SuperMK15/ARC_Reactor_PCB/Arc_Reactor_PCB.step

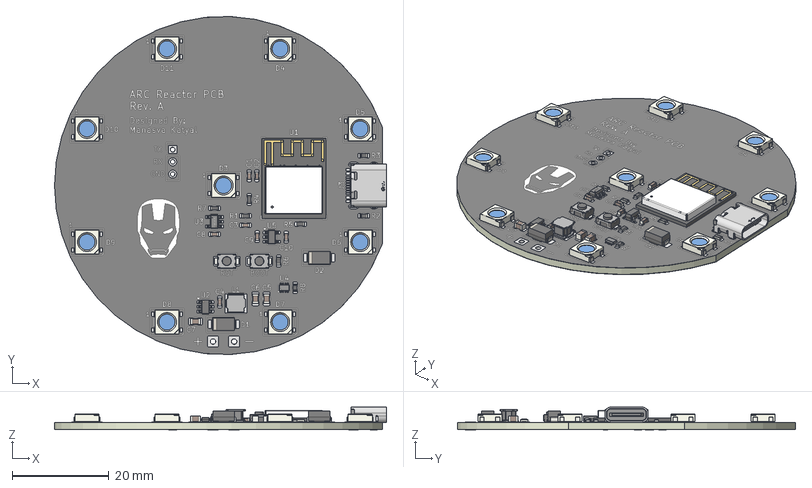
[picture p2: CAD file, 2026-10-19]
Arc_Reactor_PCB.step
68.7 x 70.0 x 4.76 mm
C_0603_1608Metric x 7
IND-SMD_L4.0-W4.0-H2.6_FNR40XXS
R_0603_1608Metric x 8
TSOT-23-6
LED_WS2812B_PLCC4_5.0x5.0mm_P3.2mm x 9
SOT-23-5_L2.9-W1.6-H1.1-LS2.8-P0.95
SW_SPST_TS-1088-xR020 x 2
DFN1006.STEP^DFN1006.STEP_Submodel-SOD882_part_DesignRootModel_PCB_ ESP32-C3-MINI-1_V1(2)_PCB_ESP32-C3-MINI-1_V1
R0201_20210301.STEP^R0201_20210301.STEP_Submodel-R0201_part_ DesignRootModel_PCB_ESP32-C3-MINI-1_V1(2)_PCB_ESP32-C3-MINI-1_V1 x 3
placementOutline^Submodel-noModelForPart_MINI-ANT-TYPED-H_1968823293_ Submodel-MINI-ANT-TYPED-H_1968823293_part_DesignRootModel_PCB_ ESP32-C3-MINI-1_V1(2)_PCB_E
placementOutline-0^Submodel-noModelForPart_MINI-ANT-TYPED-H_1968823293_ Submodel-MINI-ANT-TYPED-H_1968823293_part_DesignRootModel_PCB_ ESP32-C3-MINI-1_V1(2)_PCB
placementOutline-1^Submodel-noModelForPart_MINI-ANT-TYPED-H_1968823293_ Submodel-MINI-ANT-TYPED-H_1968823293_part_DesignRootModel_PCB_ ESP32-C3-MINI-1_V1(2)_PCB
placementOutline-2^Submodel-noModelForPart_MINI-ANT-TYPED-H_1968823293_ Submodel-MINI-ANT-TYPED-H_1968823293_part_DesignRootModel_PCB_ ESP32-C3-MINI-1_V1(2)_PCB
placementOutline-3^Submodel-noModelForPart_MINI-ANT-TYPED-H_1968823293_ Submodel-MINI-ANT-TYPED-H_1968823293_part_DesignRootModel_PCB_ ESP32-C3-MINI-1_V1(2)_PCB
placementOutline-4^Submodel-noModelForPart_MINI-ANT-TYPED-H_1968823293_ Submodel-MINI-ANT-TYPED-H_1968823293_part_DesignRootModel_PCB_ ESP32-C3-MINI-1_V1(2)_PCB
placementOutline-5^Submodel-noModelForPart_MINI-ANT-TYPED-H_1968823293_ Submodel-MINI-ANT-TYPED-H_1968823293_part_DesignRootModel_PCB_ ESP32-C3-MINI-1_V1(2)_PCB
trace_4^Submodel-MINI-ANT-TYPED-H_1968823293_part_DesignRootModel_PCB_ ESP32-C3-MINI-1_V1(2)_PCB_ESP32-C3-MINI-1_V1
trace_1^Submodel-MINI-ANT-TYPED-H_1968823293_part_DesignRootModel_PCB_ ESP32-C3-MINI-1_V1(2)_PCB_ESP32-C3-MINI-1_V1
C0402_20210301.STEP^C0402_20210301.STEP_Submodel-C0402_part_ DesignRootModel_PCB_ESP32-C3-MINI-1_V1(2)_PCB_ESP32-C3-MINI-1_V1
C0201_20210301.STEP^C0201_20210301.STEP_Submodel-C0201_part_ DesignRootModel_PCB_ESP32-C3-MINI-1_V1(2)_PCB_ESP32-C3-MINI-1_V1 x 11
L0201_20210301.STEP^L0201_20210301.STEP_Submodel-L0201_part_ DesignRootModel_PCB_ESP32-C3-MINI-1_V1(2)_PCB_ESP32-C3-MINI-1_V1 x 2
XTAL3225_20210301.STEP^XTAL3225_20210301.STEP_Submodel-XTAL3225_part_ DesignRootModel_PCB_ESP32-C3-MINI-1_V1(2)_PCB_ESP32-C3-MINI-1_V1
ESP32-C3_20210301.STEP^ESP32-C3_20210301.STEP_Submodel-QFN32_0P5_5_ part_DesignRootModel_PCB_ESP32-C3-MINI-1_V1(2)_PCB_ESP32-C3-MINI-1_V1
uid__4^DesignRootModel_PCB_ESP32-C3-MINI-1_V1(2)_PCB_ESP32-C3-MINI-1_ V1
uid__4-22^DesignRootModel_PCB_ESP32-C3-MINI-1_V1(2)_PCB_ ESP32-C3-MINI-1_V1
uid__4-23^DesignRootModel_PCB_ESP32-C3-MINI-1_V1(2)_PCB_ ESP32-C3-MINI-1_V1
uid__4-24^DesignRootModel_PCB_ESP32-C3-MINI-1_V1(2)_PCB_ ESP32-C3-MINI-1_V1
uid__4-25^DesignRootModel_PCB_ESP32-C3-MINI-1_V1(2)_PCB_ ESP32-C3-MINI-1_V1
uid__4-26^DesignRootModel_PCB_ESP32-C3-MINI-1_V1(2)_PCB_ ESP32-C3-MINI-1_V1
uid__4-27^DesignRootModel_PCB_ESP32-C3-MINI-1_V1(2)_PCB_ ESP32-C3-MINI-1_V1
uid__4-28^DesignRootModel_PCB_ESP32-C3-MINI-1_V1(2)_PCB_ ESP32-C3-MINI-1_V1
uid__4-29^DesignRootModel_PCB_ESP32-C3-MINI-1_V1(2)_PCB_ ESP32-C3-MINI-1_V1
uid__4-30^DesignRootModel_PCB_ESP32-C3-MINI-1_V1(2)_PCB_ ESP32-C3-MINI-1_V1
uid__4-31^DesignRootModel_PCB_ESP32-C3-MINI-1_V1(2)_PCB_ ESP32-C3-MINI-1_V1
uid__4-32^DesignRootModel_PCB_ESP32-C3-MINI-1_V1(2)_PCB_ ESP32-C3-MINI-1_V1
uid__4-33^DesignRootModel_PCB_ESP32-C3-MINI-1_V1(2)_PCB_ ESP32-C3-MINI-1_V1
uid__4-34^DesignRootModel_PCB_ESP32-C3-MINI-1_V1(2)_PCB_ ESP32-C3-MINI-1_V1
uid__4-35^DesignRootModel_PCB_ESP32-C3-MINI-1_V1(2)_PCB_ ESP32-C3-MINI-1_V1
uid__4-36^DesignRootModel_PCB_ESP32-C3-MINI-1_V1(2)_PCB_ ESP32-C3-MINI-1_V1
uid__4-37^DesignRootModel_PCB_ESP32-C3-MINI-1_V1(2)_PCB_ ESP32-C3-MINI-1_V1
uid__4-38^DesignRootModel_PCB_ESP32-C3-MINI-1_V1(2)_PCB_ ESP32-C3-MINI-1_V1
uid__4-39^DesignRootModel_PCB_ESP32-C3-MINI-1_V1(2)_PCB_ ESP32-C3-MINI-1_V1
uid__4-40^DesignRootModel_PCB_ESP32-C3-MINI-1_V1(2)_PCB_ ESP32-C3-MINI-1_V1
uid__4-41^DesignRootModel_PCB_ESP32-C3-MINI-1_V1(2)_PCB_ ESP32-C3-MINI-1_V1
uid__4-42^DesignRootModel_PCB_ESP32-C3-MINI-1_V1(2)_PCB_ ESP32-C3-MINI-1_V1
uid__4-43^DesignRootModel_PCB_ESP32-C3-MINI-1_V1(2)_PCB_ ESP32-C3-MINI-1_V1
uid__4-44^DesignRootModel_PCB_ESP32-C3-MINI-1_V1(2)_PCB_ ESP32-C3-MINI-1_V1
uid__4-45^DesignRootModel_PCB_ESP32-C3-MINI-1_V1(2)_PCB_ ESP32-C3-MINI-1_V1
uid__4-46^DesignRootModel_PCB_ESP32-C3-MINI-1_V1(2)_PCB_ ESP32-C3-MINI-1_V1
uid__4-47^DesignRootModel_PCB_ESP32-C3-MINI-1_V1(2)_PCB_ ESP32-C3-MINI-1_V1
uid__4-48^DesignRootModel_PCB_ESP32-C3-MINI-1_V1(2)_PCB_ ESP32-C3-MINI-1_V1
uid__4-49^DesignRootModel_PCB_ESP32-C3-MINI-1_V1(2)_PCB_ ESP32-C3-MINI-1_V1
uid__4-50^DesignRootModel_PCB_ESP32-C3-MINI-1_V1(2)_PCB_ ESP32-C3-MINI-1_V1
uid__4-51^DesignRootModel_PCB_ESP32-C3-MINI-1_V1(2)_PCB_ ESP32-C3-MINI-1_V1
uid__4-52^DesignRootModel_PCB_ESP32-C3-MINI-1_V1(2)_PCB_ ESP32-C3-MINI-1_V1
uid__4-53^DesignRootModel_PCB_ESP32-C3-MINI-1_V1(2)_PCB_ ESP32-C3-MINI-1_V1
uid__4-54^DesignRootModel_PCB_ESP32-C3-MINI-1_V1(2)_PCB_ ESP32-C3-MINI-1_V1
uid__4-55^DesignRootModel_PCB_ESP32-C3-MINI-1_V1(2)_PCB_ ESP32-C3-MINI-1_V1
uid__4-56^DesignRootModel_PCB_ESP32-C3-MINI-1_V1(2)_PCB_ ESP32-C3-MINI-1_V1
uid__4-57^DesignRootModel_PCB_ESP32-C3-MINI-1_V1(2)_PCB_ ESP32-C3-MINI-1_V1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
