SuperMK15/ARC_Reactor_PCB/Arc_Reactor_PCB.pdf

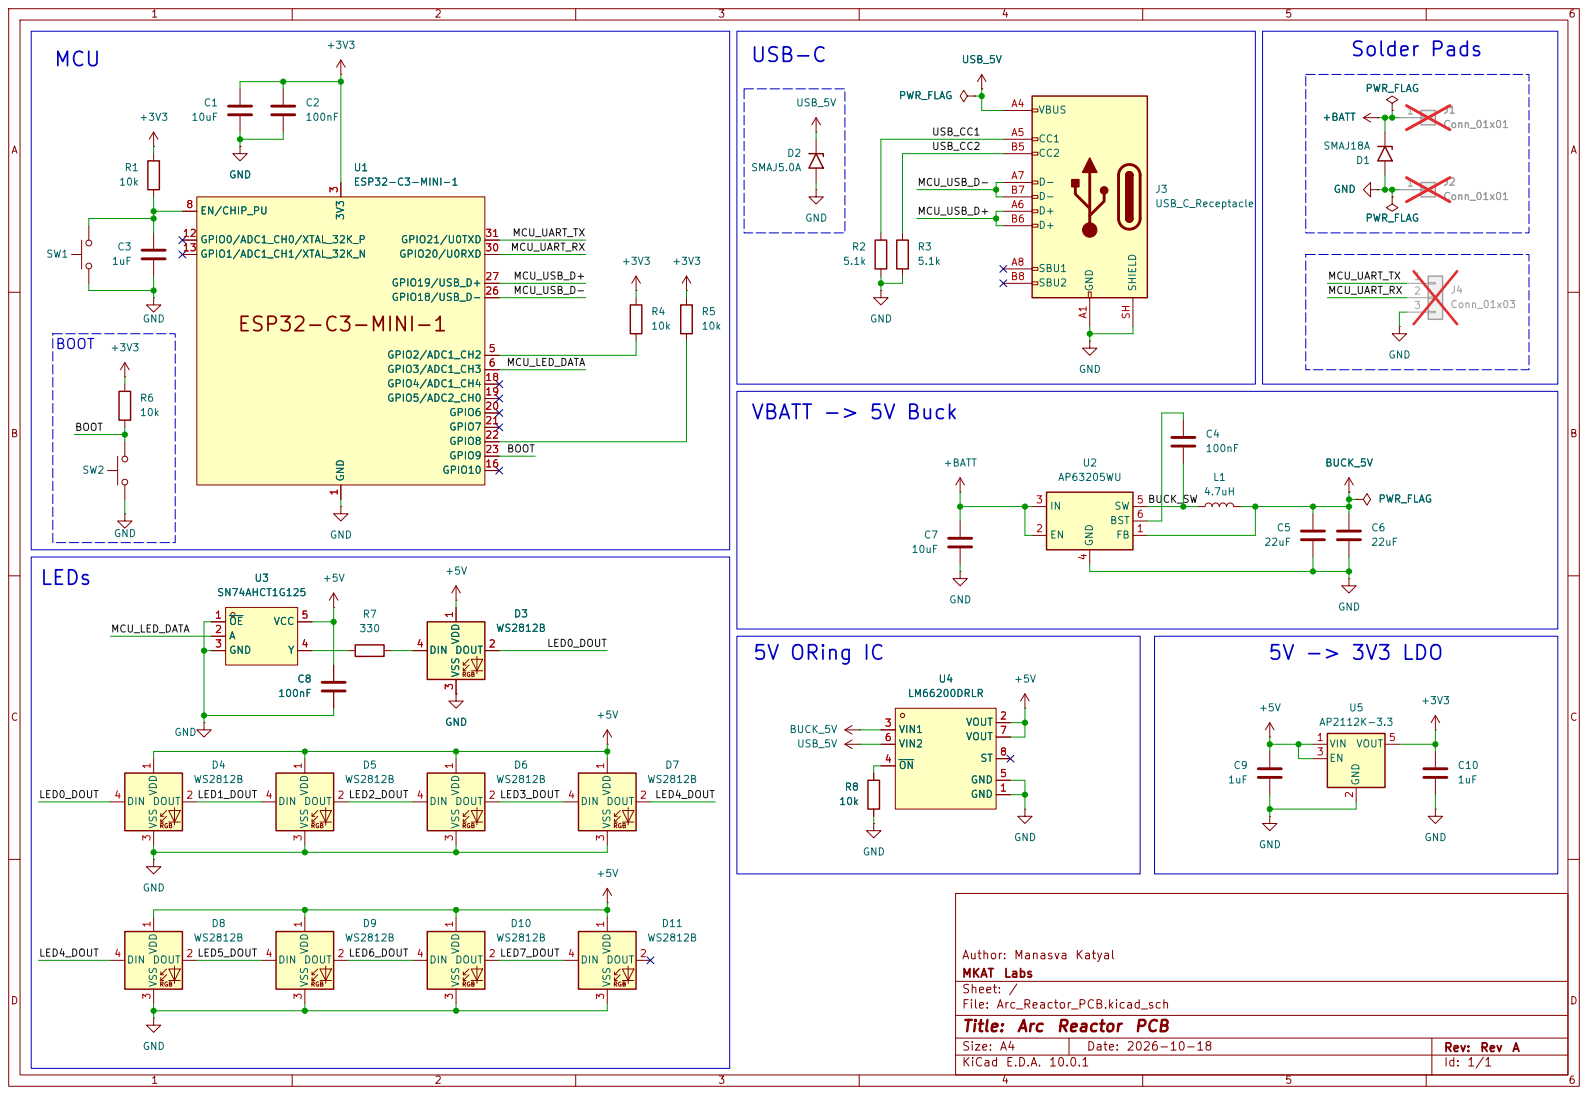
[picture p3: page 1]

Author: Manasva Katyal
MKAT Labs
Sheet: /
File: Arc_Reactor_PCB.kicad_sch
Title: Arc Reactor PCB

Size: A4 | Rev: Rev A
KiCad E.D.A. 10.0.1 | Id: 1/1
