SuperMK15/ARC_Reactor_PCB/Arc_Reactor_PCB.kicad_pcb

## KiCad design Arc_Reactor_PCB.kicad_pcb (2026-10-19)

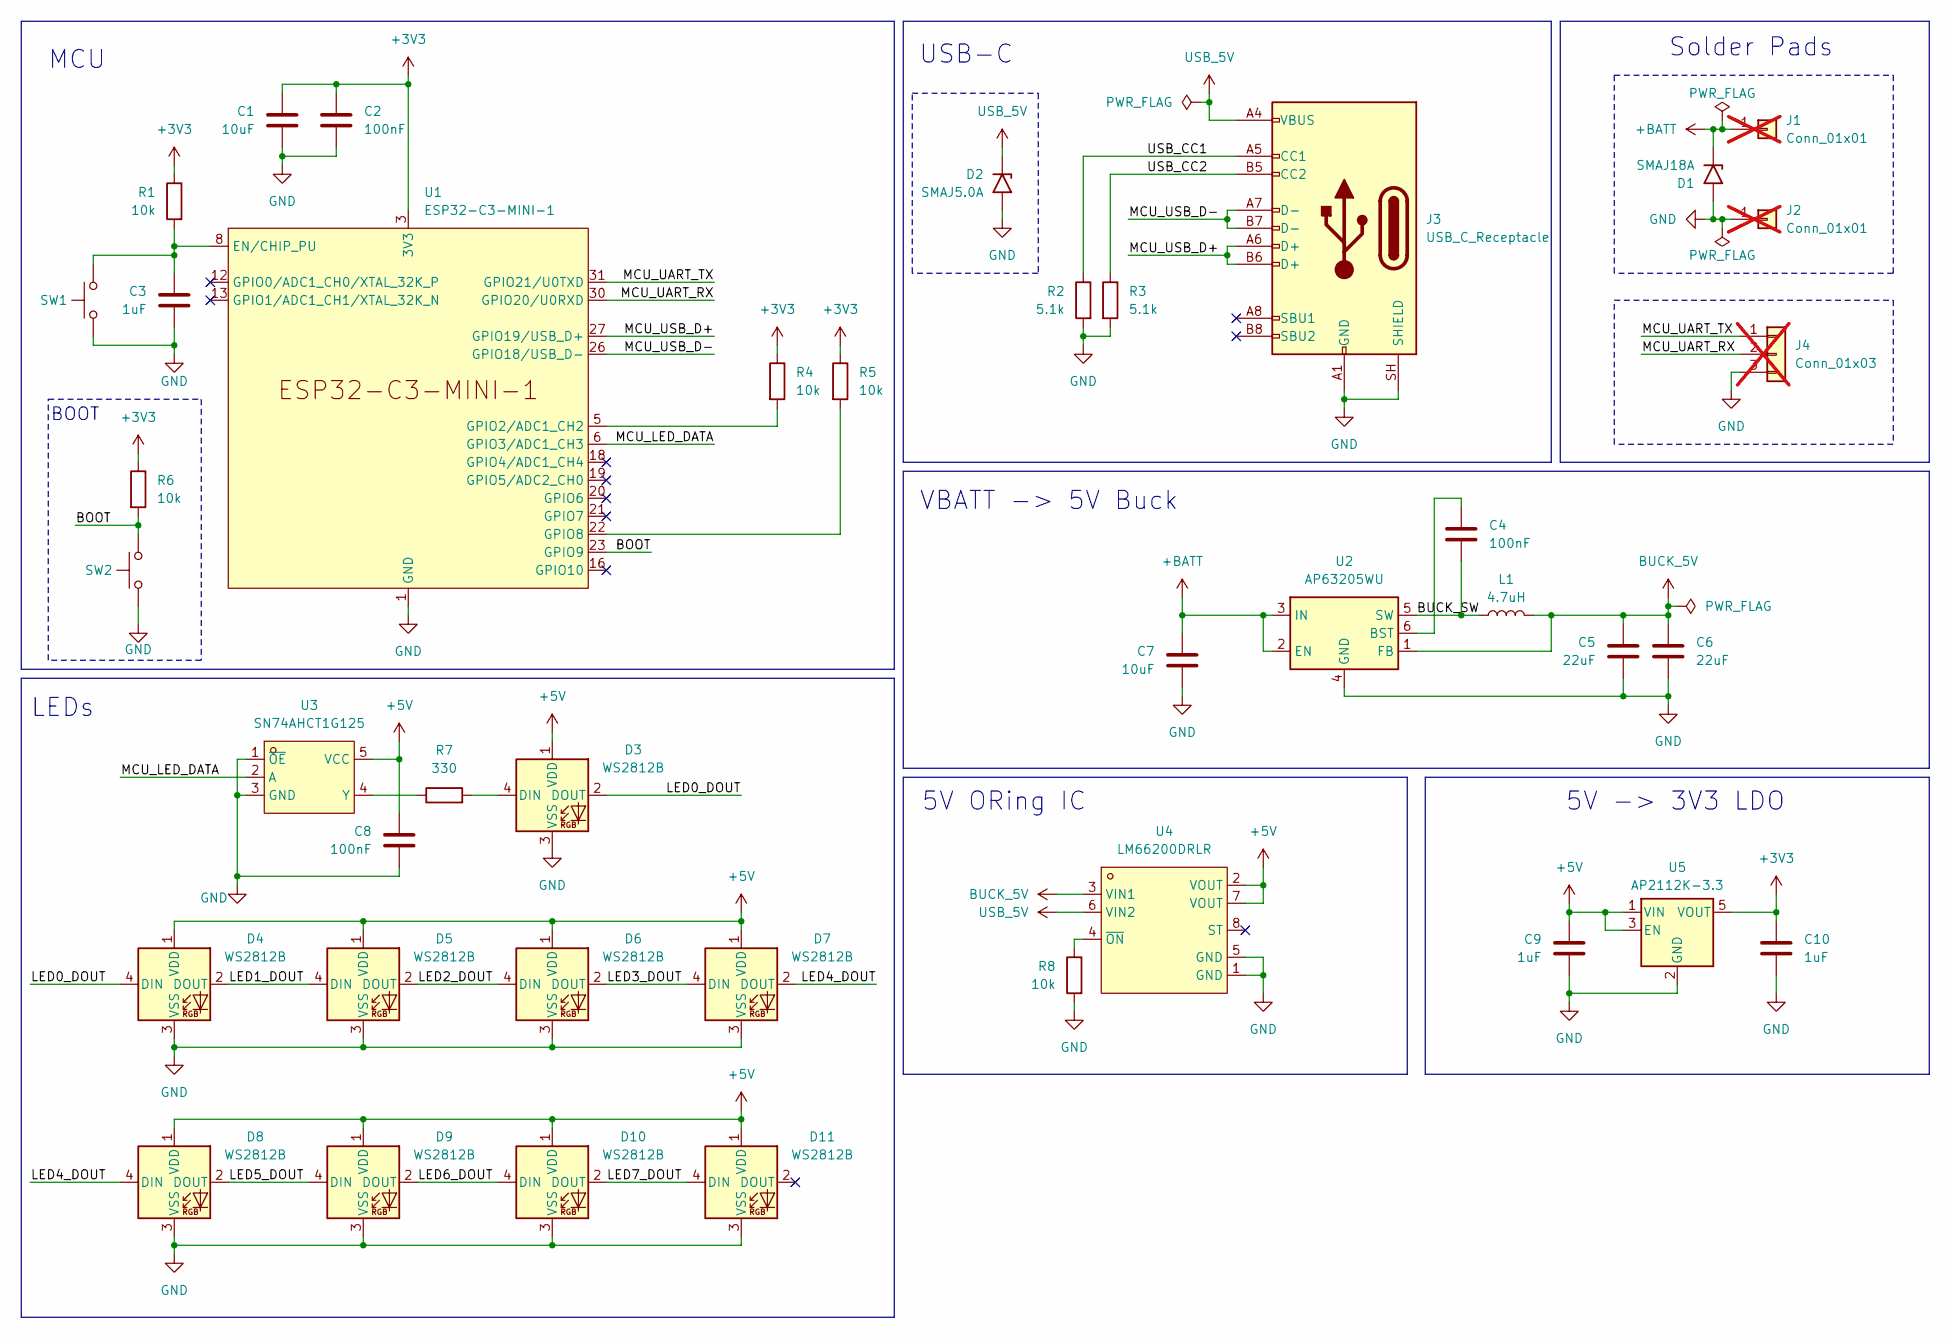
[picture p4: schematic Arc_Reactor_PCB.kicad_sch, Arc Reactor PCB]

Parts:
C1: 10uF; C_0603_1608Metric; LCSC C19702
C2, C4, C8: 100nF; C_0603_1608Metric; LCSC C14663
C3, C9, C10: 1uF; C_0603_1608Metric; LCSC C90540
C5, C6: 22uF; C_0805_2012Metric; LCSC C45783
C7: 10uF; C_0805_2012Metric; LCSC C318691
D1: SMAJ18A; D_SMA; LCSC C134965
D2: SMAJ5.0A; D_SMA; LCSC C83329
D3, D4, D5, D6, D7, D8, D9, D10, D11: WS2812B; LED_WS2812B_PLCC4_5.0x5.0mm_P3.2mm; LCSC C114586
J1, J2: Conn_01x01; SolderWire-0.5sqmm_1x01_D0.9mm_OD2.3mm; not fitted
J3: USB_C_Receptacle; USB_C_Receptacle_HRO_TYPE-C-31-M-12; LCSC C2765186
J4: Conn_01x03; PinHeader_1x03_P2.54mm_Vertical; not fitted
L1: 4.7uH; IND-SMD_L4.0-W4.0_FNR40XXS; LCSC C167874
R1, R4, R5, R6, R8: 10k; R_0603_1608Metric; LCSC C98220
R2, R3: 5.1k; R_0603_1608Metric; LCSC C23186
R7: 330; R_0603_1608Metric; LCSC C23138
SW1, SW2: SW_Push; SW_SPST_TS-1088-xR020; LCSC C720477
U1: ESP32-C3-MINI-1; LCSC C2838502
U2: AP63205WU; TSOT-23-6; LCSC C2071056
U3: SN74AHCT1G125; SOT-23-5_L3.0-W1.7-P0.95-LS2.8-BR; LCSC Part C7484
U4: LM66200DRLR; SOT-583-8_L2.1-W1.2-P0.50-LS1.6-BL; LCSC Part C3235556
U5: AP2112K-3.3; SOT-23-5; LCSC C51118

Connections:
+3V3: C1.2, C2.2, C10.2, R1.1, R4.1, R5.1, R6.1, U1.3 (3V3), U5.5 (VOUT)
+5V: C8.2, C9.2, D3.1 (VDD), D4.1 (VDD), D5.1 (VDD), D6.1 (VDD), D7.1 (VDD), D8.1 (VDD), D9.1 (VDD), D10.1 (VDD), D11.1 (VDD), U3.5 (VCC), U4.2 (VOUT), U4.7 (VOUT), U5.1 (VIN), U5.3 (EN)
+BATT: C7.2, D1.1 (A1), J1.1 (Pin_1_1), U2.2 (EN), U2.3 (IN)
/BOOT: R6.2, SW2.2, U1.23 (GPIO9)
/BUCK_SW: C4.1, L1.1, U2.5 (SW)
/LED0_DOUT: D3.2 (DOUT), D4.4 (DIN)
/LED1_DOUT: D4.2 (DOUT), D5.4 (DIN)
/LED2_DOUT: D5.2 (DOUT), D6.4 (DIN)
/LED3_DOUT: D6.2 (DOUT), D7.4 (DIN)
/LED4_DOUT: D7.2 (DOUT), D8.4 (DIN)
/LED5_DOUT: D8.2 (DOUT), D9.4 (DIN)
/LED6_DOUT: D9.2 (DOUT), D10.4 (DIN)
/LED7_DOUT: D10.2 (DOUT), D11.4 (DIN)
/MCU_LED_DATA: U1.6 (GPIO3/ADC1_CH3), U3.2 (A)
/MCU_UART_RX: J4.2, U1.30 (GPIO20/U0RXD)
/MCU_UART_TX: J4.1, U1.31 (GPIO21/U0TXD)
/MCU_USB_D+: J3.A6 (D+), J3.B6 (D+), U1.27 (GPIO19/USB_D+)
/MCU_USB_D-: J3.A7 (D-), J3.B7 (D-), U1.26 (GPIO18/USB_D-)
/USB_CC1: J3.A5 (CC1), R2.1
/USB_CC2: J3.B5 (CC2), R3.1
BUCK_5V: C5.2, C6.2, L1.2, U2.1 (FB), U4.3 (VIN1)
GND: C1.1, C2.1, C3.1, C5.1, C6.1, C7.1, C8.1, C9.1, C10.1, D1.2 (A2), D2.2 (A2), D3.3 (VSS), D4.3 (VSS), D5.3 (VSS), D6.3 (VSS), D7.3 (VSS), D8.3 (VSS), D9.3 (VSS), D10.3 (VSS), D11.3 (VSS), J2.1 (Pin_1_1), J3.A1 (GND), J3.A12 (GND), J3.B1 (GND), J3.B12 (GND), J3.SH (SHIELD), J4.3, R2.2, R3.2, R8.2, SW1.1, SW2.1, U1.1 (GND), U1.2 (GND), U1.11 (GND), U1.14 (GND), U1.36 (GND), U1.37 (GND), U1.38 (GND), U1.39 (GND), U1.40 (GND), U1.41 (GND), U1.42 (GND), U1.43 (GND), U1.44 (GND), U1.45 (GND), U1.46 (GND), U1.47 (GND), U1.48 (GND), U1.49 (GND), U1.50 (GND), U1.51 (GND), U1.52 (GND), U1.53 (GND), U2.4 (GND), U3.1 (~OE), U3.3 (GND), U4.1 (GND), U4.5 (GND), U5.2 (GND)
unnamed: D3.4 (DIN), R7.2
unnamed: C3.2, R1.2, SW1.2, U1.8 (EN/CHIP_PU)
unnamed: R4.2, U1.5 (GPIO2/ADC1_CH2)
unnamed: R5.2, U1.22 (GPIO8)
unnamed: C4.2, U2.6 (BST)
unnamed: R7.1, U3.4 (Y)
unnamed: R8.1, U4.4 (~ON)
USB_5V: D2.1 (A1), J3.A4 (VBUS), J3.A9 (VBUS), J3.B4 (VBUS), J3.B9 (VBUS), U4.6 (VIN2)

Notes on the sheet:
MCU
BOOT
USB-C
Solder Pads
VBATT -> 5V Buck
5V -> 3V3 LDO
LEDs
5V ORing IC

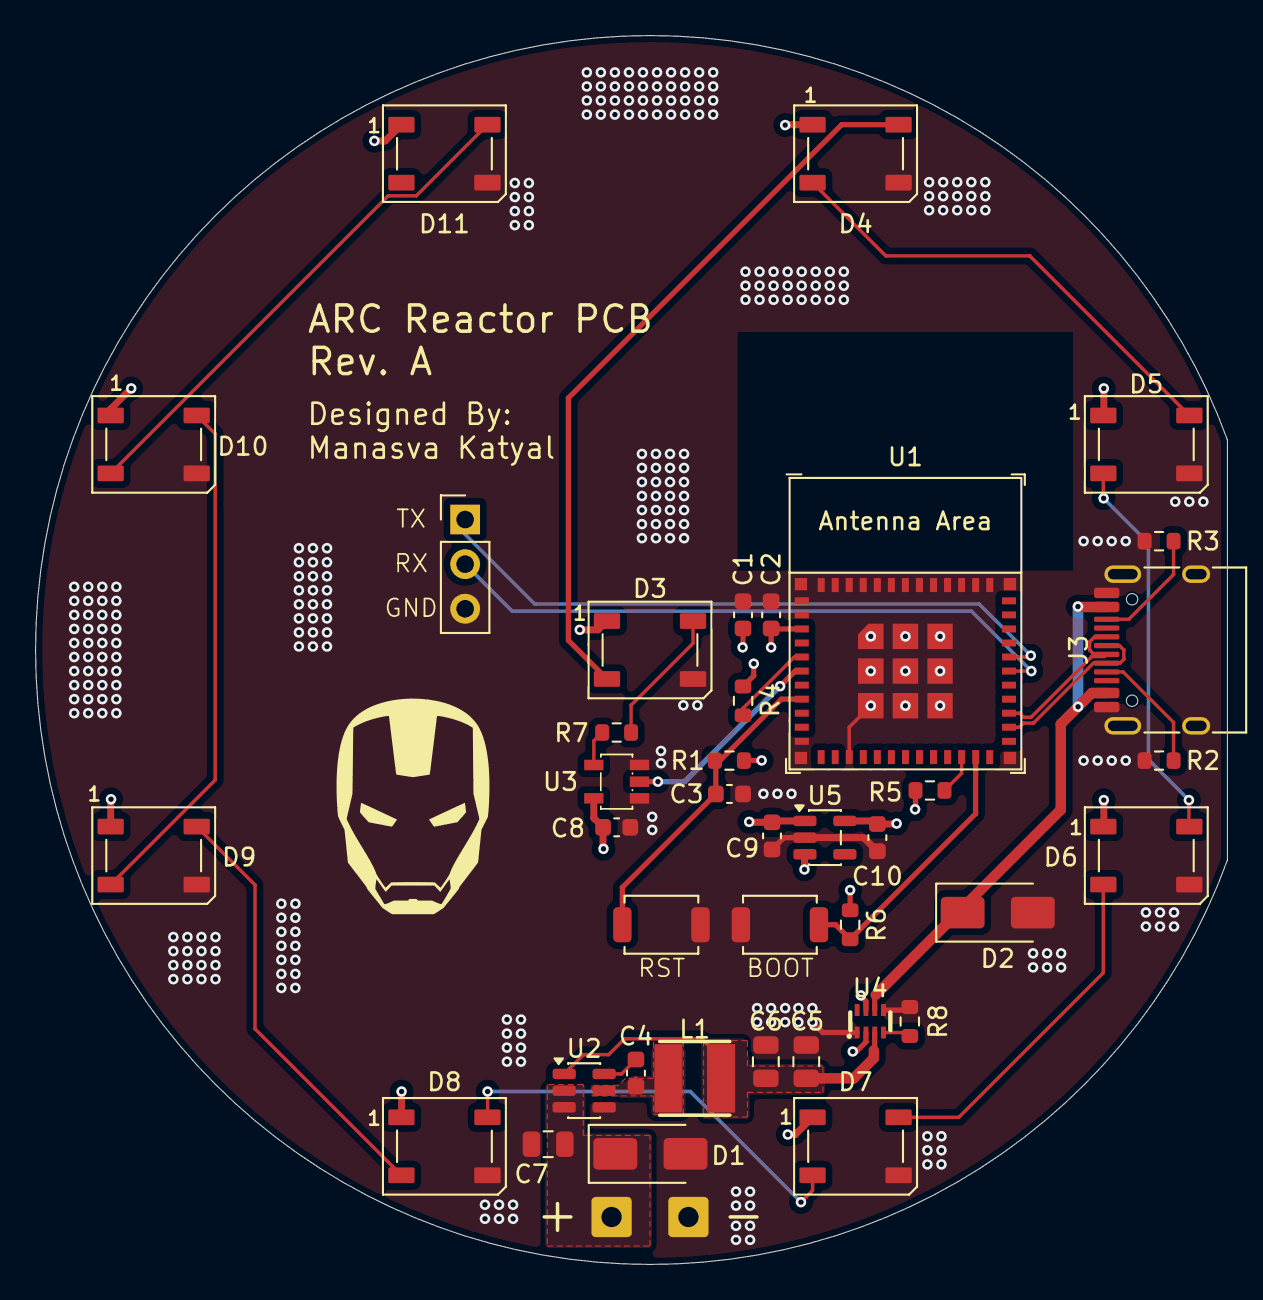
[picture p5: board Arc_Reactor_PCB.kicad_pcb from above]

Board: 4 copper layers, 67.9 x 70.0 mm, 43 parts (1 on the bottom side), 30 nets.

Other parts of the board:
G1, G2: LOGO
