SuperMK15/ARC_Reactor_PCB/(commit log)

2026-10-17 Revise README with project details and features
    Updated project name and added detailed features, PCB layers, and design files information.
2026-10-18 Improve WIFI Antenna Keepout
    [Arc_Reactor_PCB.kicad_pcb]
2026-10-18 Minor cleanup
    [Arc_Reactor_PCB.kicad_pcb]
2026-10-18 Updates for production
    [Arc_Reactor_PCB.kicad_pcb, Arc_Reactor_PCB.kicad_sch]
2026-10-18 Add STEP file
    [Arc_Reactor_PCB.step]
2026-10-18 Improve placement/routing
    [Arc_Reactor_PCB.kicad_pcb, Arc_Reactor_PCB.kicad_sch, Arc_Reactor_PCB.step]
2026-10-18 Add SMAJ5.0A TVS on USB VBUS
    [Arc_Reactor_PCB.kicad_pcb, Arc_Reactor_PCB.kicad_sch, Arc_Reactor_PCB.step]
2026-10-18 Update Back Silkscreen with Arc Reactor SVG
    [Arc_Reactor_PCB.kicad_pcb, Arc_Reactor_PCB.step]
2026-10-18 Update BOM
    [Arc_Reactor_PCB.kicad_pcb, Arc_Reactor_PCB.kicad_sch]
2026-10-19 feat: ESP32-C3 firmware package
2026-10-19 Trim board edge flat at USB-C
    [Arc_Reactor_PCB.kicad_pcb, Arc_Reactor_PCB.step]
2026-10-29 Add interactice BOM page
2026-10-31 Improve ESP32 Firmware Web AP UI
